Bruin-Spacecraft-Group/Rapid-EPS-12V-DC-Converter/README.md

# Rapid-EPS-12V-DC-Converter
PCB, operational instructions, other random stuff for use on 12V line for Rapid.
