Bruin-Spacecraft-Group/Rapid-EPS-12V-DC-Converter/HIGH-POWER-12V_Converter_LM51231-Q1/design notes.txt

------------------------------
custom from webench:

n-mosfet: 60V for radiation:
SIR180DP-T1-RE3

inductor: 2.2u,
HCMA1707-330-R

capacitor - Cout (in place of the polarized one on webench):
anything 0603

------------------------------
components not available for PICK-N-PLACE:
- Cvcc
- Css
- L1
- Ccomp
- Rsense
- U1
- Cout
