Bruin-Spacecraft-Group/Rapid-EPS-12V-DC-Converter/HIGH-POWER-12V_Converter_LM51231-Q1/12V_Converter_LM5152x-Q1/imported libraries/TRANS_NVMFS5834NLWFT1G/TRANS_NVMFS5834NLWFT1G.step

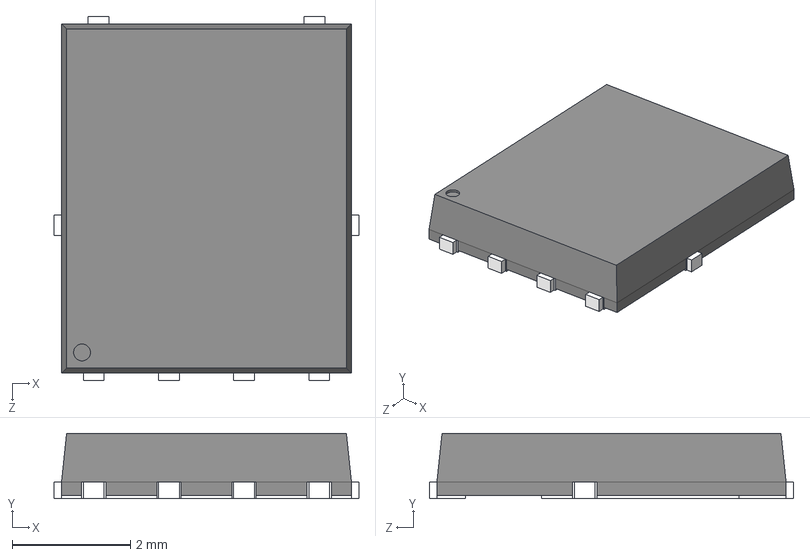
[picture p1: CAD file, 2023-04-18]
HIGH-POWER-12V_Converter_LM51231-Q1/12V_Converter_LM5152x-Q1/imported libraries/TRANS_NVMFS5834NLWFT1G/TRANS_NVMFS5834NLWFT1G.step
5.15 x 1.10 x 6.15 mm
