Bruin-Spacecraft-Group/Rapid-EPS-12V-DC-Converter/HIGH-POWER-12V_Converter_LM51231-Q1/12V_Converter_LM5152x-Q1/imported libraries/CSD18540Q5B/CSD18540Q5B.step

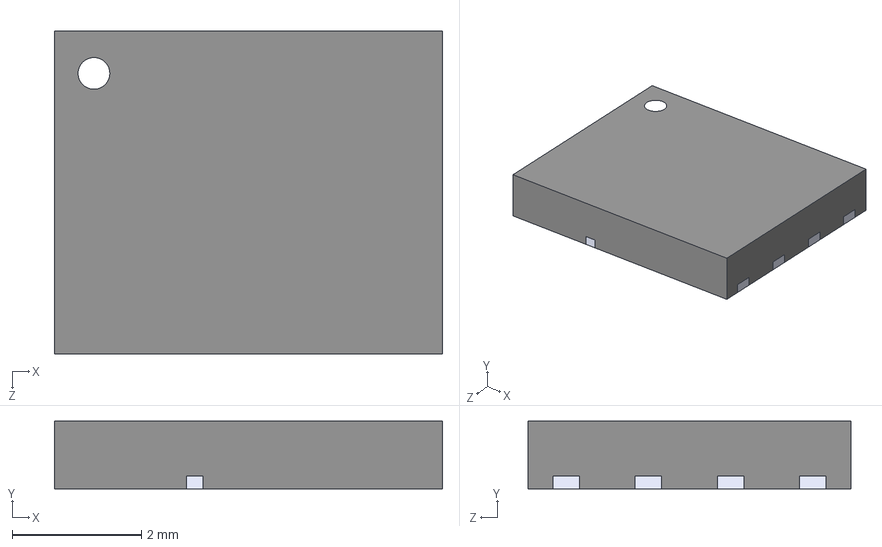
[picture p2: CAD file, 2023-04-18]
HIGH-POWER-12V_Converter_LM51231-Q1/12V_Converter_LM5152x-Q1/imported libraries/CSD18540Q5B/CSD18540Q5B.step
6.00 x 1.05 x 5.00 mm
