Bruin-Spacecraft-Group/Rapid-EPS-12V-DC-Converter/12V_Converter_TPS611781/12V_Converter_TPS611781.kicad_pcb

## KiCad design 12V_Converter_TPS611781/12V_Converter_TPS611781.kicad_pcb (2023-01-30)

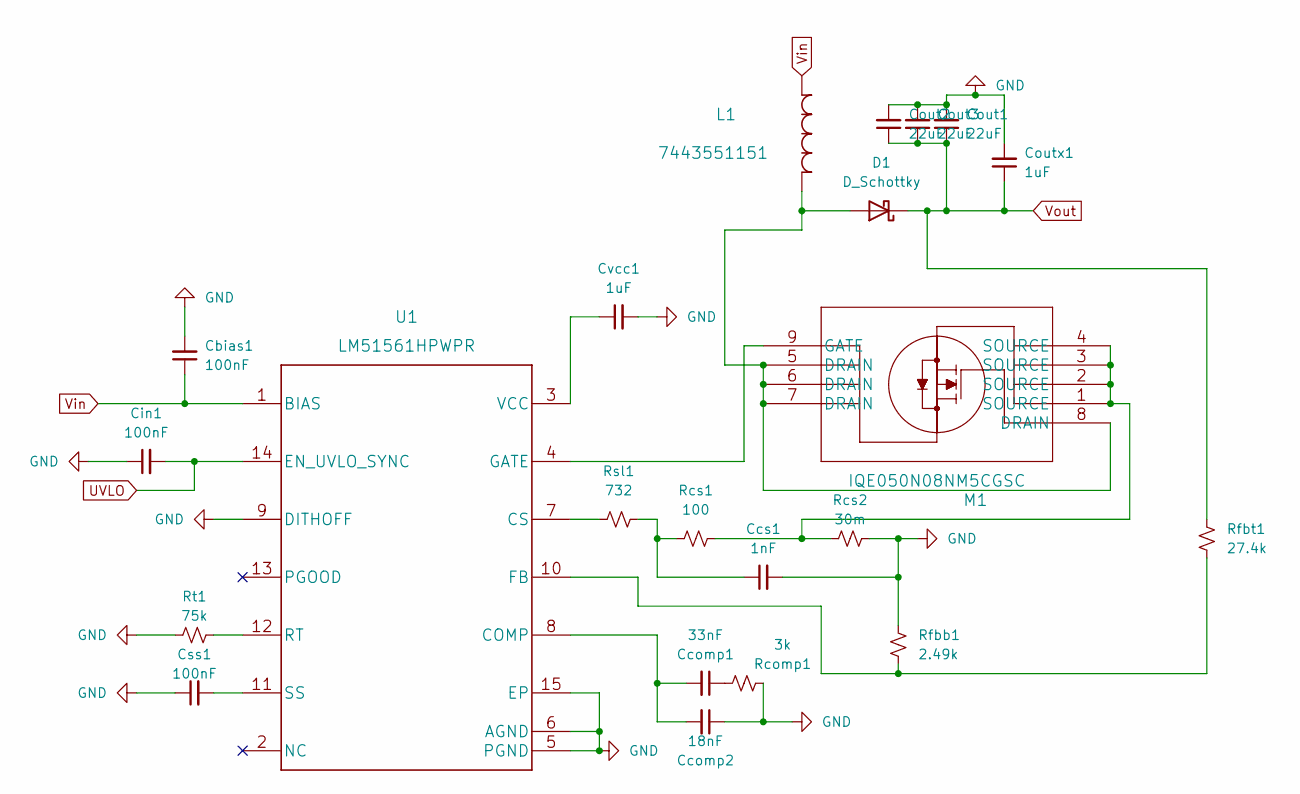
[picture p5: schematic 12V_Converter_TPS611781.kicad_sch]

Parts:
Cbias1: 100nF; C_0805_2012Metric
Ccomp1: 33nF; C_0805_2012Metric
Ccomp2: 18nF; C_0805_2012Metric
Ccs1: 1nF; C_0805_2012Metric
Cin1: 100nF; C_1206_3216Metric
Cout1, Cout2, Cout3: 22uF; C_1210_3225Metric
Coutx1: 1uF; C_0805_2012Metric
Css1: 100nF; C_0805_2012Metric
Cvcc1: 1uF; C_0603_1608Metric
D1: D_Schottky; D_SOD-128
L1: 7443551151
M1: IQE050N08NM5CGSC; IQE050N08NM5CGATMA1
Rcomp1: 3k; R_0603_1608Metric
Rcs1: 100; R_0805_2012Metric
Rcs2: 30m; R_1206_3216Metric
Rfbb1: 2.49k; R_0603_1608Metric
Rfbt1: 27.4k; R_0603_1608Metric
Rsl1: 732; R_0805_2012Metric
Rt1: 75k; R_0805_2012Metric
U1: LM51561HPWPR

Connections:
GND: Cbias1.2, Ccomp2.1, Ccs1.2, Cin1.1, Cout1.2, Cout2.2, Cout3.2, Coutx1.2, Css1.1, Cvcc1.2, Rcomp1.1, Rcs2.2, Rfbb1.2, Rt1.1, U1.5 (PGND), U1.6 (AGND), U1.9 (DITHOFF), U1.15 (EP); also elsewhere on the board
unnamed: Ccomp1.1, Rcomp1.2
unnamed: Ccomp1.2, Ccomp2.2, U1.8 (COMP)
unnamed: Ccs1.1, Rcs1.1, Rsl1.2
unnamed: Css1.2, U1.11 (SS)
unnamed: Cvcc1.1, U1.3 (VCC)
unnamed: D1.2 (A), L1.1, M1.5 (DRAIN), M1.6 (DRAIN), M1.7 (DRAIN), M1.8 (DRAIN)
unnamed: M1.9 (GATE), U1.4 (GATE)
unnamed: M1.1 (SOURCE), M1.2 (SOURCE), M1.3 (SOURCE), M1.4 (SOURCE), Rcs1.2, Rcs2.1
unnamed: Rfbb1.1, Rfbt1.1, U1.10 (FB)
unnamed: Rsl1.1, U1.7 (CS)
unnamed: Rt1.2, U1.12 (RT)
UVLO: Cin1.2, U1.14 (EN_UVLO_SYNC)
Vin: Cbias1.1, L1.2, U1.1 (BIAS)
Vout: Cout1.1, Cout2.1, Cout3.1, Coutx1.1, D1.1 (K), Rfbt1.2; also elsewhere on the board

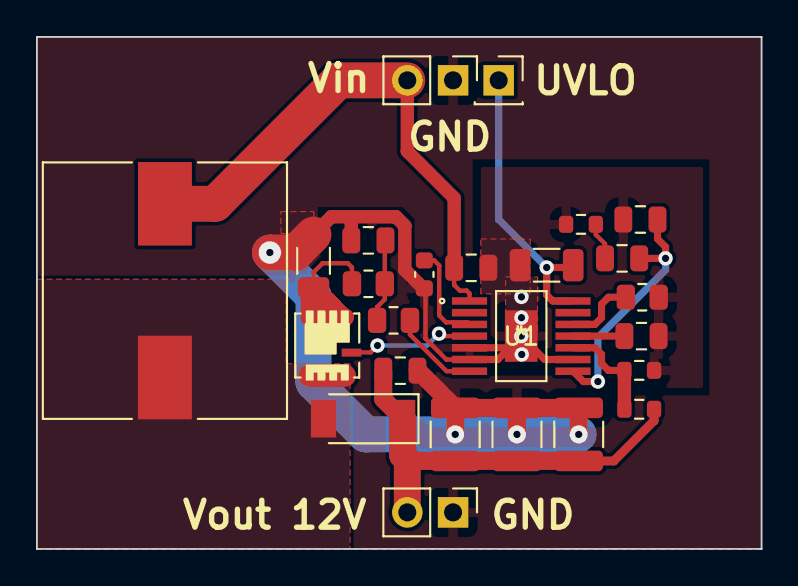
[picture p6: board 12V_Converter_TPS611781.kicad_pcb from above]

Board: 2 copper layers, 40.3 x 28.4 mm, 23 parts (0 on the bottom side), 15 nets.

Other parts of the board:
REF: PinHeader_1x02_P2.54mm_Vertical

Their connections:
GND: REF.1; also elsewhere on the board
Vout: REF.2; also elsewhere on the board
