Bruin-Spacecraft-Group/Rapid-EPS-12V-DC-Converter/HIGH-POWER-12V_Converter_LM51521-Q1/12V_Converter_LM5152x-Q1/12V_Converter_LM5152x-Q1.kicad_sch

## KiCad design HIGH-POWER-12V_Converter_LM51521-Q1/12V_Converter_LM5152x-Q1/12V_Converter_LM5152x-Q1.kicad_sch (2023-03-08)

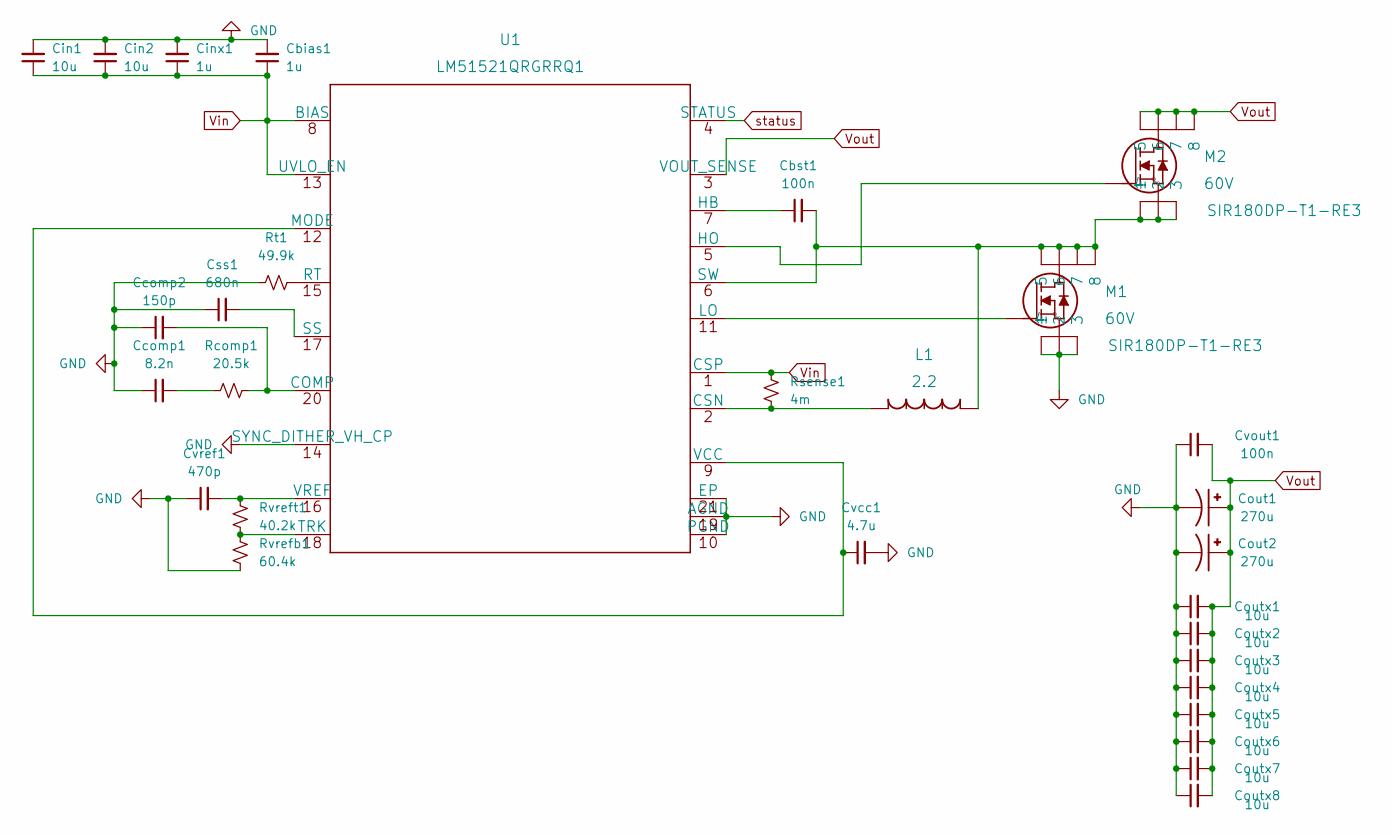
[picture p7: schematic 12V_Converter_LM5152x-Q1.kicad_sch]

Parts:
Cbias1: 1u; C_0603_1608Metric; LCSC C92759
Cbst1: 100n; C_0603_1608Metric; LCSC C92759
Ccomp1: 8.2n; C_0805_2012Metric
Ccomp2: 150p; C_0805_2012Metric; LCSC C107111
Cin1, Cin2: 10u; C_1206_3216Metric; LCSC C77093
Cinx1: 1u; C_0603_1608Metric; LCSC C2172920
Cout1, Cout2: 270u; CAP_EEHZS1H271UP
Coutx1, Coutx2, Coutx3, Coutx4, Coutx5, Coutx6, Coutx7, Coutx8: 10u; C_1206_3216Metric; LCSC C77093
Css1: 680n; C_0603_1608Metric
Cvcc1: 4.7u; C_0603_1608Metric
Cvout1: 100n; C_0603_1608Metric; LCSC C2842861
Cvref1: 470p; C_0603_1608Metric; LCSC C85979
L1: 2.2; IHLP6767GZER2R2M51
M1, M2: 60V; SIR826ADP-T1-GE3; LCSC C5334421
Rcomp1: 20.5k; R_0603_1608Metric; LCSC C273789
Rsense1: 4m; R_2512_6332Metric
Rt1: 49.9k; R_0603_1608Metric; LCSC C844171
Rvrefb1: 60.4k; R_0603_1608Metric; LCSC C165742
Rvreft1: 40.2k; R_0603_1608Metric; LCSC C844784
U1: LM51521QRGRRQ1

Connections:
GND: Cbias1.2, Ccomp1.1, Ccomp2.1, Cin1.2, Cin2.2, Cinx1.2, Cout1.2, Cout2.2, Coutx1.1, Coutx2.1, Coutx3.1, Coutx4.1, Coutx5.1, Coutx6.1, Coutx7.1, Coutx8.1, Css1.1, Cvcc1.2, Cvout1.1, Cvref1.1, M1.1, M1.2, M1.3, Rt1.1, Rvrefb1.2, U1.10 (PGND), U1.14 (SYNC_DITHER_VH_CP), U1.19 (AGND), U1.21 (EP)
unnamed: Cbst1.1, U1.7 (HB)
unnamed: Cbst1.2, L1.1, M1.5, M1.6, M1.7, M1.8, M2.1, M2.2, M2.3, U1.6 (SW)
unnamed: Ccomp1.2, Rcomp1.1
unnamed: Ccomp2.2, Rcomp1.2, U1.20 (COMP)
unnamed: Css1.2, U1.17 (SS)
unnamed: Cvcc1.1, U1.9 (VCC), U1.12 (MODE)
unnamed: Cvref1.2, Rvreft1.1, U1.16 (VREF)
unnamed: L1.2, Rsense1.2, U1.2 (CSN)
unnamed: M1.4, U1.11 (LO)
unnamed: M2.4, U1.5 (HO)
unnamed: Rt1.2, U1.15 (RT)
unnamed: Rvrefb1.1, Rvreft1.2, U1.18 (TRK)
Vin: Cbias1.1, Cin1.1, Cin2.1, Cinx1.1, Rsense1.1, U1.1 (CSP), U1.8 (BIAS), U1.13 (UVLO_EN)
Vout: Cout1.1, Cout2.1, Coutx1.2, Coutx2.2, Coutx3.2, Coutx4.2, Coutx5.2, Coutx6.2, Coutx7.2, Coutx8.2, Cvout1.2, M2.5, M2.6, M2.7, M2.8, U1.3 (VOUT_SENSE)
status: U1.4 (STATUS)
