Bruin-Spacecraft-Group/Rapid-EPS-12V-DC-Converter/(commit log)

2023-01-29 created initial pcb
    [12V_Converter_TPS611781.kicad_pcb, 12V_Converter_TPS611781.kicad_sch]
2023-01-30 changed components
    - changed inductor to be better resistance
    - changed ic to be qfp instead of qfn
    - changed N MOSFET to be 100V instead of 30V
    - separated UVLO from Vin to allow for UVLO operation if needed (added external connect pin)
    [12V_Converter_TPS611781.kicad_pcb, 12V_Converter_TPS611781.kicad_sch]
2023-01-30 notes on diodes
    [12V_Converter_TPS611781.kicad_sch]
2023-01-30 actually added pcb edge
    [12V_Converter_TPS611781.kicad_pcb]
2023-01-30 got rid of soldermask on component
    [12V_Converter_TPS611781.kicad_pcb]
2023-01-30 made things better :)
    moved current sense resistor closer to the spot that senses the current
    [12V_Converter_TPS611781.kicad_pcb]
2023-01-30 reduced switching loop area
    [12V_Converter_TPS611781.kicad_pcb, 12V_Converter_TPS611781.kicad_sch]
2023-01-30 corrected vin location on schematic
    [12V_Converter_TPS611781.kicad_sch]
2023-01-30 shifted traces
    [12V_Converter_TPS611781.kicad_pcb]
2023-01-30 made traces chonky
    [12V_Converter_TPS611781.kicad_pcb]
2023-01-30 made traces EXTRA CHONKY
    [12V_Converter_TPS611781.kicad_pcb]
2023-01-30 made more traces chonky
    [12V_Converter_TPS611781.kicad_pcb]
2023-01-30 bro idek
    [12V_Converter_TPS611781.kicad_pcb]
2023-01-30 updated cvcc orientation
    [12V_Converter_TPS611781.kicad_pcb]
2023-01-30 closed closer loop
    [12V_Converter_TPS611781.kicad_pcb]
2023-01-30 shifted some things over to the right and got rid of the ground river in the middle
    [12V_Converter_TPS611781.kicad_pcb]
2023-01-30 shifted trace to actually align with vout lolololololo
    [12V_Converter_TPS611781.kicad_pcb]
2023-01-30 got rid of the massive short
    [12V_Converter_TPS611781.kicad_pcb]
2023-01-30 moved gnd silkmask
    [12V_Converter_TPS611781.kicad_pcb]
2023-01-30 fix GND side of current sense probe and DRC issues
    [12V_Converter_TPS611781.kicad_pcb]
2023-01-30 improve thermals
    [12V_Converter_TPS611781.kicad_pcb]
2023-01-30 added back the auxiliary diodes, which got annhialated for some reason
    [12V_Converter_TPS611781.kicad_sch]
2023-01-31 created gerber files
    [12V_Converter_TPS611781-B_Cu.gbl, 12V_Converter_TPS611781-B_Mask.gbs, 12V_Converter_TPS611781-B_Paste.gbp, 12V_Converter_TPS611781-B_Silkscreen.gbo, 12V_Converter_TPS611781-Edge_Cuts.gm1, 12V_Converter_TPS611781-F_Cu.gtl, 12V_Converter_TPS611781-F_Mask.gts, 12V_Converter_TPS611781-F_Paste.gtp]
2023-03-07 created high power 12V converter schematic and pcb
    [12V_Converter_LM5152x-Q1.kicad_pcb, 12V_Converter_LM5152x-Q1.kicad_sch]
2023-03-07 added some jlcpcb pick n place files
    [12V_Converter_LM5152x-Q1.kicad_pcb, 12V_Converter_LM5152x-Q1.kicad_sch]
2023-03-07 updated current sense line
    [12V_Converter_LM5152x-Q1-B_Cu.gbl, 12V_Converter_LM5152x-Q1-B_Mask.gbs, 12V_Converter_LM5152x-Q1-B_Paste.gbp, 12V_Converter_LM5152x-Q1-B_Silkscreen.gbo, 12V_Converter_LM5152x-Q1-Edge_Cuts.gm1, 12V_Converter_LM5152x-Q1-F_Cu.gtl, 12V_Converter_LM5152x-Q1-F_Mask.gts, 12V_Converter_LM5152x-Q1-F_Paste.gtp]
2023-03-07 ngl idek
    [12V_Converter_LM5152x-Q1.kicad_pcb]
2023-03-08 updated from reviews
    - changed capacitor
    - changed output capacitors
    - moved a bunch of stuff around and filled in a lot of copper area
    [12V_Converter_LM5152x-Q1.kicad_pcb, 12V_Converter_LM5152x-Q1.kicad_sch, EEHZS1H271UP.step]
2023-03-08 made some changed
    [12V_Converter_LM5152x-Q1-B_Cu.gbl, 12V_Converter_LM5152x-Q1-B_Mask.gbs, 12V_Converter_LM5152x-Q1-B_Paste.gbp, 12V_Converter_LM5152x-Q1-B_Silkscreen.gbo, 12V_Converter_LM5152x-Q1-Edge_Cuts.gm1, 12V_Converter_LM5152x-Q1-F_Cu.gtl, 12V_Converter_LM5152x-Q1-F_Mask.gts, 12V_Converter_LM5152x-Q1-F_Paste.gtp]
2023-03-08 changed folder name
    [12V_Converter_LM5152x-Q1-B_Cu.gbl, 12V_Converter_LM5152x-Q1-B_Mask.gbs, 12V_Converter_LM5152x-Q1-B_Paste.gbp, 12V_Converter_LM5152x-Q1-B_Silkscreen.gbo, 12V_Converter_LM5152x-Q1-Edge_Cuts.gm1, 12V_Converter_LM5152x-Q1-F_Cu.gtl, 12V_Converter_LM5152x-Q1-F_Mask.gts, 12V_Converter_LM5152x-Q1-F_Paste.gtp]
2023-03-08 added bom sheet and actually added a pcb border
    [12V_Converter_LM5152x-Q1-B_Cu.gbl, 12V_Converter_LM5152x-Q1-B_Mask.gbs, 12V_Converter_LM5152x-Q1-B_Paste.gbp, 12V_Converter_LM5152x-Q1-B_Silkscreen.gbo, 12V_Converter_LM5152x-Q1-Edge_Cuts.gm1, 12V_Converter_LM5152x-Q1-F_Cu.gtl, 12V_Converter_LM5152x-Q1-F_Mask.gts, 12V_Converter_LM5152x-Q1-F_Paste.gtp]
2023-04-18 updated mosfets on high power 12V
    [12V_Converter_LM5152x-Q1.kicad_pcb, 12V_Converter_LM5152x-Q1.kicad_sch, CSD18540Q5B.step, TRANS_NVMFS5834NLWFT1G.step]
2023-04-19 add review notes
    [12V_Converter_LM5152x-Q1.kicad_sch]
2023-04-21 updated high power to reflect changes described in review notes
    [12V_Converter_LM5152x-Q1.kicad_pcb, 12V_Converter_LM5152x-Q1.kicad_sch]
2023-04-25 literally not a clue what i did i think i made some gerber files or smth
    [12V_Converter_LM5152x-Q1-B_Cu.gbl, 12V_Converter_LM5152x-Q1-B_Mask.gbs, 12V_Converter_LM5152x-Q1-B_Paste.gbp, 12V_Converter_LM5152x-Q1-B_Silkscreen.gbo, 12V_Converter_LM5152x-Q1-Edge_Cuts.gm1, 12V_Converter_LM5152x-Q1-F_Cu.gtl, 12V_Converter_LM5152x-Q1-F_Mask.gts, 12V_Converter_LM5152x-Q1-F_Paste.gtp]
