Bruin-Spacecraft-Group/Rapid-EPS-12V-DC-Converter/(notices)

Notices in the files:
parts and their libraries:
Copyright 2021 Accelerated Designs. All rights reserved.
